DrItanium/i960SxProcessorCard/README.md

A 4-layer PCB meant to break the control signals of an i960Sx processor in the
form of an Arduino Mega 2560 shield. I designed this board to make sure that I
would not have to continually make 4-layer boards on multiple screw ups.
