DrItanium/i960SxProcessorCard/i960SxProcessorMegaShieldFormFactor.kicad_pcb

## KiCad design i960SxProcessorMegaShieldFormFactor.kicad_pcb (2022-12-09)

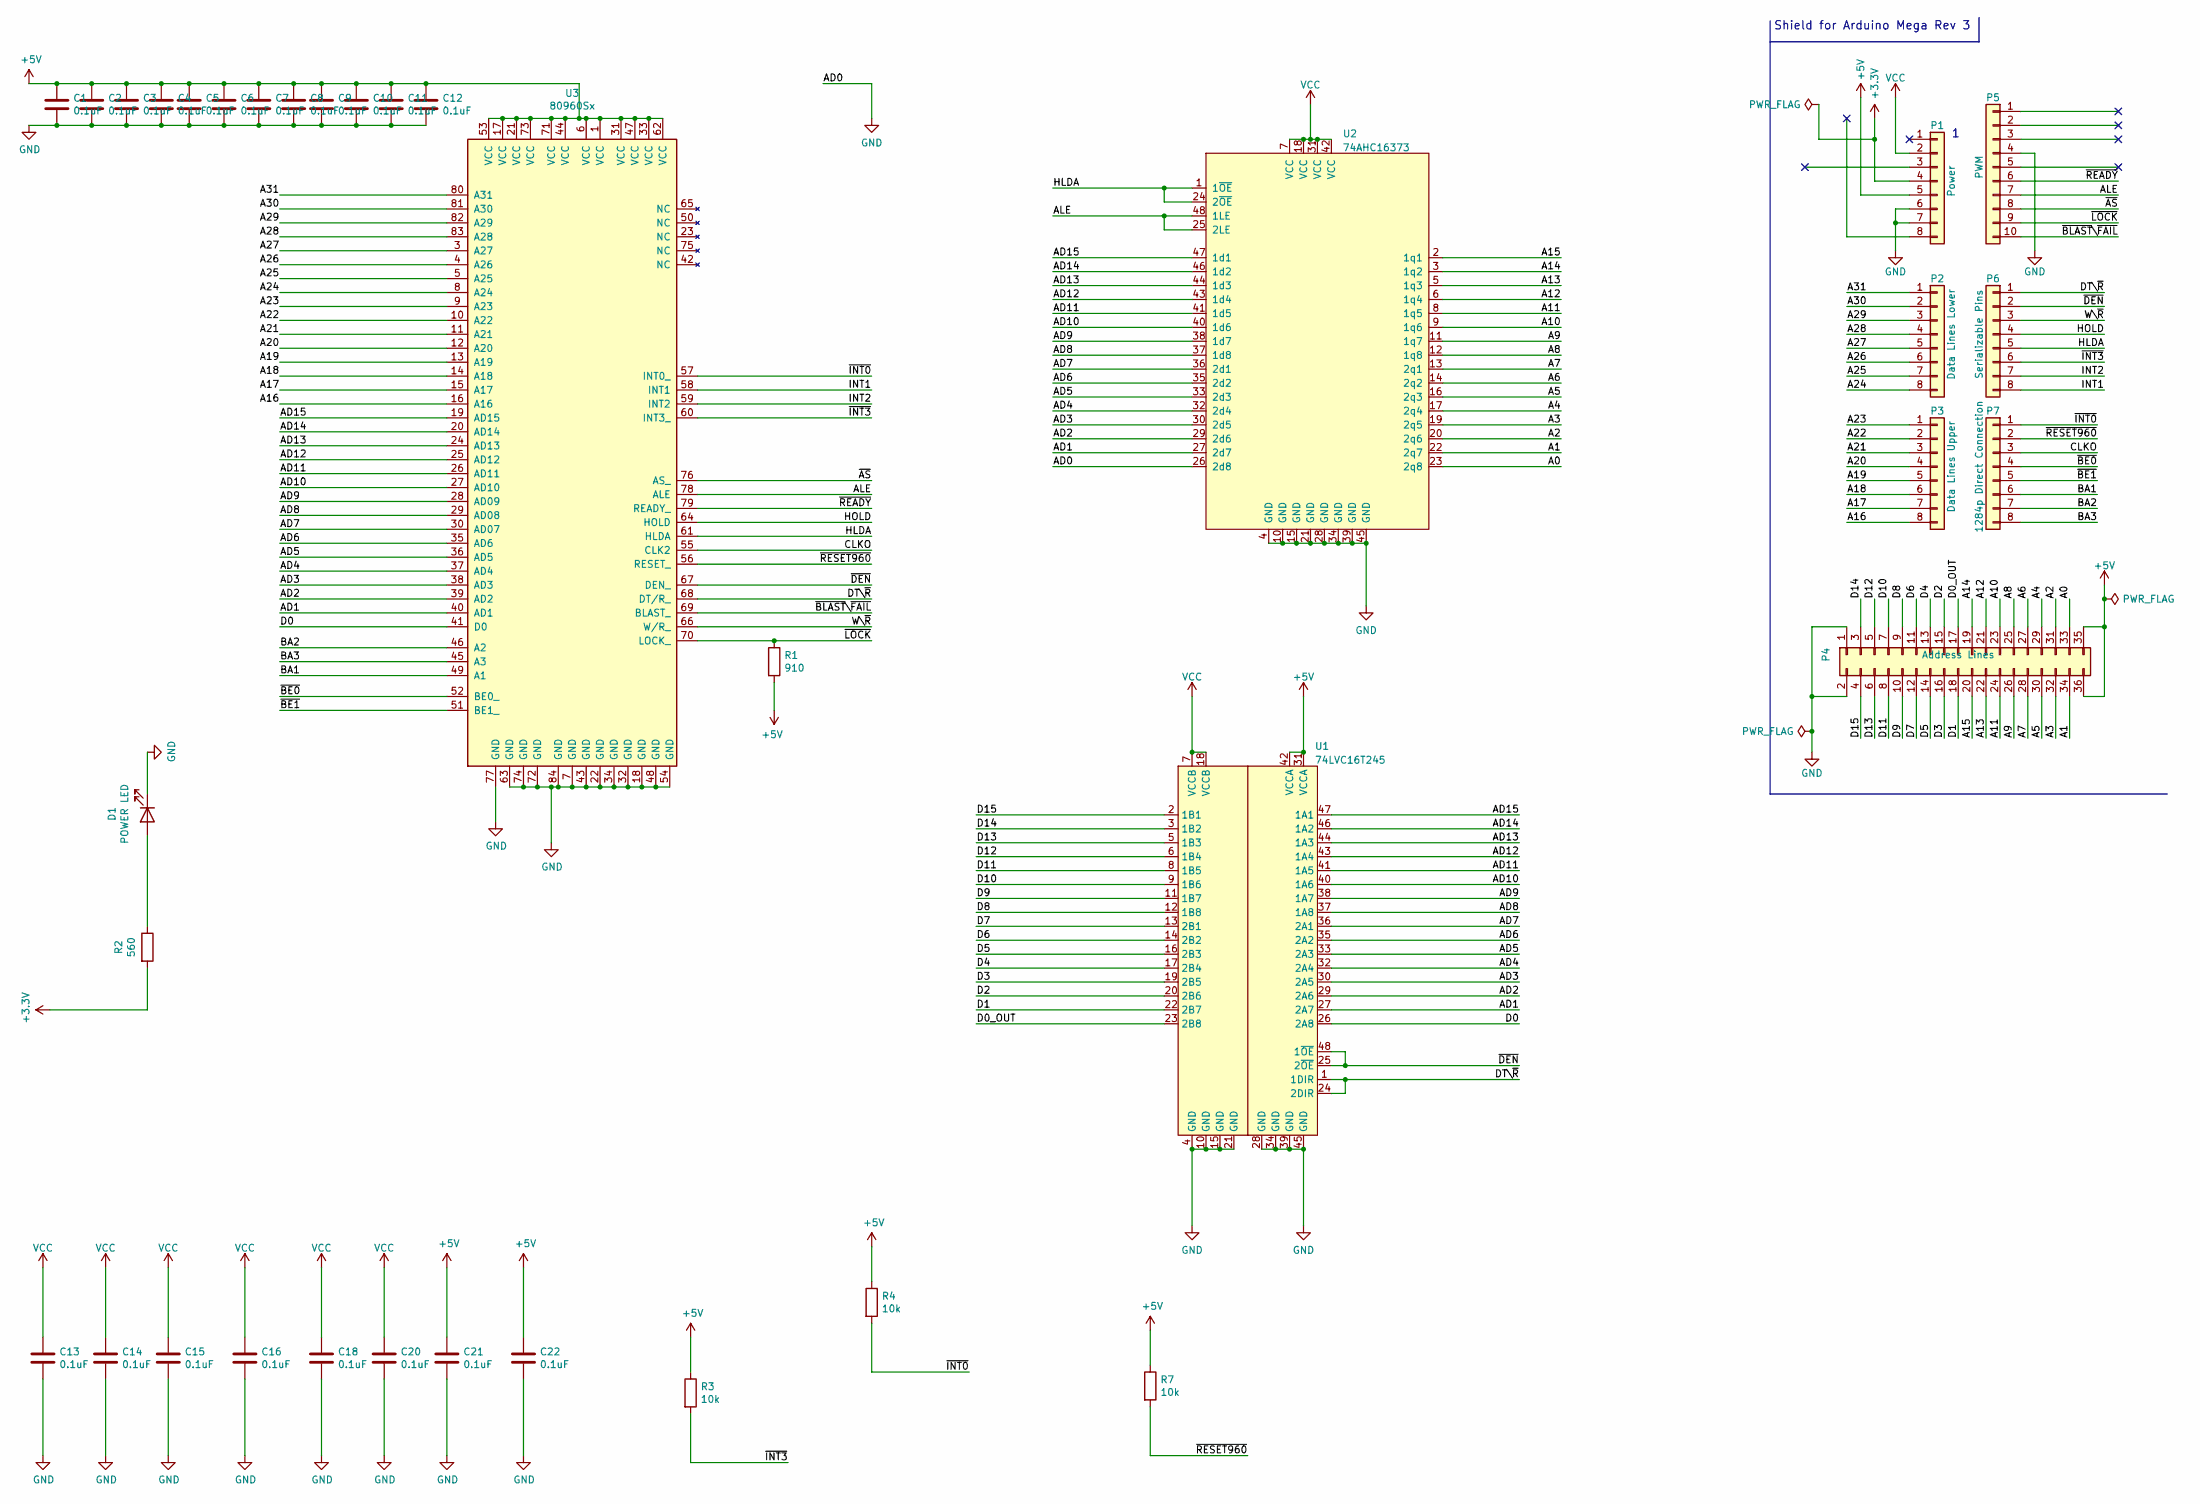
[picture p1: schematic i960SxProcessorMegaShieldFormFactor.kicad_sch, i960Sx Mega Shield Without direct connection to a mega]

Parts:
C1, C2, C3, C4, C5, C6, C7, C8, C9, C10, C11, C12, C13, C14, C15, C16, C18, C20, C21, C22: 0.1uF; C_0805_2012Metric_Pad1.18x1.45mm_HandSolder
D1: POWER LED; LED_0805_2012Metric
P1: Power; Socket_Strip_Arduino_1x08
P2: Data Lines Lower; Socket_Strip_Arduino_1x08
P3: Data Lines Upper; Socket_Strip_Arduino_1x08
P4: Address Lines; Socket_Strip_Arduino_2x18
P5: PWM; Socket_Strip_Arduino_1x10
P6: Serializable Pins; Socket_Strip_Arduino_1x08
P7: 1284p Direct Connection; Socket_Strip_Arduino_1x08
R1: 910; R_0805_2012Metric_Pad1.20x1.40mm_HandSolder
R2: 560; R_0805_2012Metric_Pad1.20x1.40mm_HandSolder
R3, R4, R7: 10k; R_0805_2012Metric_Pad1.20x1.40mm_HandSolder
U1: 74LVC16T245; TSSOP-48_6.1x12.5mm_P0.5mm
U2: 74AHC16373; TSSOP-48_6.1x12.5mm_P0.5mm
U3: 80960Sx; PLCC-84_THT-Socket

Connections:
+3V3: P1.4, R2.2
+5V: C1.1, C2.1, C3.1, C4.1, C5.1, C6.1, C7.1, C8.1, C9.1, C10.1, C11.1, C12.1, C21.1, C22.1, P1.5, P4.35, P4.36, R1.2, R3.1, R4.1, R7.1, U1.31 (VCCA), U1.42 (VCCA), U3.1 (VCC), U3.6 (VCC), U3.17 (VCC), U3.21 (VCC), U3.31 (VCC), U3.33 (VCC), U3.44 (VCC), U3.47 (VCC), U3.53 (VCC), U3.62 (VCC), U3.71 (VCC), U3.73 (VCC)
/A0: P4.33, U2.23 (2q8)
/A1: P4.34, U2.22 (2q7)
/A2: P4.31, U2.20 (2q6)
/A3: P4.32, U2.19 (2q5)
/A4: P4.29, U2.17 (2q4)
/A5: P4.30, U2.16 (2q3)
/A6: P4.27, U2.14 (2q2)
/A7: P4.28, U2.13 (2q1)
/A8: P4.25, U2.12 (1q8)
/A9: P4.26, U2.11 (1q7)
/A10: P4.23, U2.9 (1q6)
/A11: P4.24, U2.8 (1q5)
/A12: P4.21, U2.6 (1q4)
/A13: P4.22, U2.5 (1q3)
/A14: P4.19, U2.3 (1q2)
/A15: P4.20, U2.2 (1q1)
/A16: P3.8, U3.16 (A16)
/A17: P3.7, U3.15 (A17)
/A18: P3.6, U3.14 (A18)
/A19: P3.5, U3.13 (A19)
/A20: P3.4, U3.12 (A20)
/A21: P3.3, U3.11 (A21)
/A22: P3.2, U3.10 (A22)
/A23: P3.1, U3.9 (A23)
/A24: P2.8, U3.8 (A24)
/A25: P2.7, U3.5 (A25)
/A26: P2.6, U3.4 (A26)
/A27: P2.5, U3.3 (A27)
/A28: P2.4, U3.83 (A28)
/A29: P2.3, U3.82 (A29)
/A30: P2.2, U3.81 (A30)
/A31: P2.1, U3.80 (A31)
/AD1: U1.27 (2A7), U2.27 (2d7), U3.40 (AD1)
/AD2: U1.29 (2A6), U2.29 (2d6), U3.39 (AD2)
/AD3: U1.30 (2A5), U2.30 (2d5), U3.38 (AD3)
/AD4: U1.32 (2A4), U2.32 (2d4), U3.37 (AD4)
/AD5: U1.33 (2A3), U2.33 (2d3), U3.36 (AD5)
/AD6: U1.35 (2A2), U2.35 (2d2), U3.35 (AD6)
/AD7: U1.36 (2A1), U2.36 (2d1), U3.30 (AD07)
/AD8: U1.37 (1A8), U2.37 (1d8), U3.29 (AD08)
/AD9: U1.38 (1A7), U2.38 (1d7), U3.28 (AD09)
/AD10: U1.40 (1A6), U2.40 (1d6), U3.27 (AD10)
/AD11: U1.41 (1A5), U2.41 (1d5), U3.26 (AD11)
/AD12: U1.43 (1A4), U2.43 (1d4), U3.25 (AD12)
/AD13: U1.44 (1A3), U2.44 (1d3), U3.24 (AD13)
/AD14: U1.46 (1A2), U2.46 (1d2), U3.20 (AD14)
/AD15: U1.47 (1A1), U2.47 (1d1), U3.19 (AD15)
/ALE: P5.7, U2.25 (2LE), U2.48 (1LE), U3.78 (ALE)
/BA1: P7.6, U3.49 (A1)
/BA2: P7.7, U3.46 (A2)
/BA3: P7.8, U3.45 (A3)
/CLKO: P7.3, U3.55 (CLK2)
/D0: U1.26 (2A8), U3.41 (D0)
/D0_OUT: P4.17, U1.23 (2B8)
/D1: P4.18, U1.22 (2B7)
/D2: P4.15, U1.20 (2B6)
/D3: P4.16, U1.19 (2B5)
/D4: P4.13, U1.17 (2B4)
/D5: P4.14, U1.16 (2B3)
/D6: P4.11, U1.14 (2B2)
/D7: P4.12, U1.13 (2B1)
/D8: P4.9, U1.12 (1B8)
/D9: P4.10, U1.11 (1B7)
/D10: P4.7, U1.9 (1B6)
/D11: P4.8, U1.8 (1B5)
/D12: P4.5, U1.6 (1B4)
/D13: P4.6, U1.5 (1B3)
/D14: P4.3, U1.3 (1B2)
/D15: P4.4, U1.2 (1B1)
/DT\~R: P6.1, U1.1 (1DIR), U1.24 (2DIR), U3.68 (DT/R_)
/HLDA: P6.5, U2.1 (1~OE), U2.24 (2~OE), U3.61 (HLDA)
/HOLD: P6.4, U3.64 (HOLD)
/INT1: P6.8, U3.58 (INT1)
/INT2: P6.7, U3.59 (INT2)
/W\~R: P6.3, U3.66 (W/R_)
/~AS: P5.8, U3.76 (AS_)
/~BE0: P7.4, U3.52 (BE0_)
/~BE1: P7.5, U3.51 (BE1_)
/~BLAST\~FAIL: P5.10, U3.69 (BLAST_)
/~DEN: P6.2, U1.25 (2~OE), U1.48 (1~OE), U3.67 (DEN_)
/~INT0: P7.1, R4.2, U3.57 (INT0_)
/~INT3: P6.6, R3.2, U3.60 (INT3_)
/~LOCK: P5.9, R1.1, U3.70 (LOCK_)
/~READY: P5.6, U3.79 (READY_)
/~RESET960: P7.2, R7.2, U3.56 (RESET_)
GND: C1.2, C2.2, C3.2, C4.2, C5.2, C6.2, C7.2, C8.2, C9.2, C10.2, C11.2, C12.2, C13.2, C14.2, C15.2, C16.2, C18.2, C20.2, C21.2, C22.2, D1.1 (K), P1.6, P1.7, P4.1, P4.2, P5.4, U1.4 (GND), U1.10 (GND), U1.15 (GND), U1.21 (GND), U1.28 (GND), U1.34 (GND), U1.39 (GND), U1.45 (GND), U2.4 (GND), U2.10 (GND), U2.15 (GND), U2.21 (GND), U2.26 (2d8), U2.28 (GND), U2.34 (GND), U2.39 (GND), U2.45 (GND), U3.7 (GND), U3.18 (GND), U3.22 (GND), U3.32 (GND), U3.34 (GND), U3.43 (GND), U3.48 (GND), U3.54 (GND), U3.63 (GND), U3.72 (GND), U3.74 (GND), U3.77 (GND), U3.84 (GND)
unnamed: D1.2 (A), R2.1
VCC: C13.1, C14.1, C15.1, C16.1, C18.1, C20.1, P1.2, U1.7 (VCCB), U1.18 (VCCB), U2.7 (VCC), U2.18 (VCC), U2.31 (VCC), U2.42 (VCC)

Notes on the sheet:
Shield for Arduino Mega Rev 3

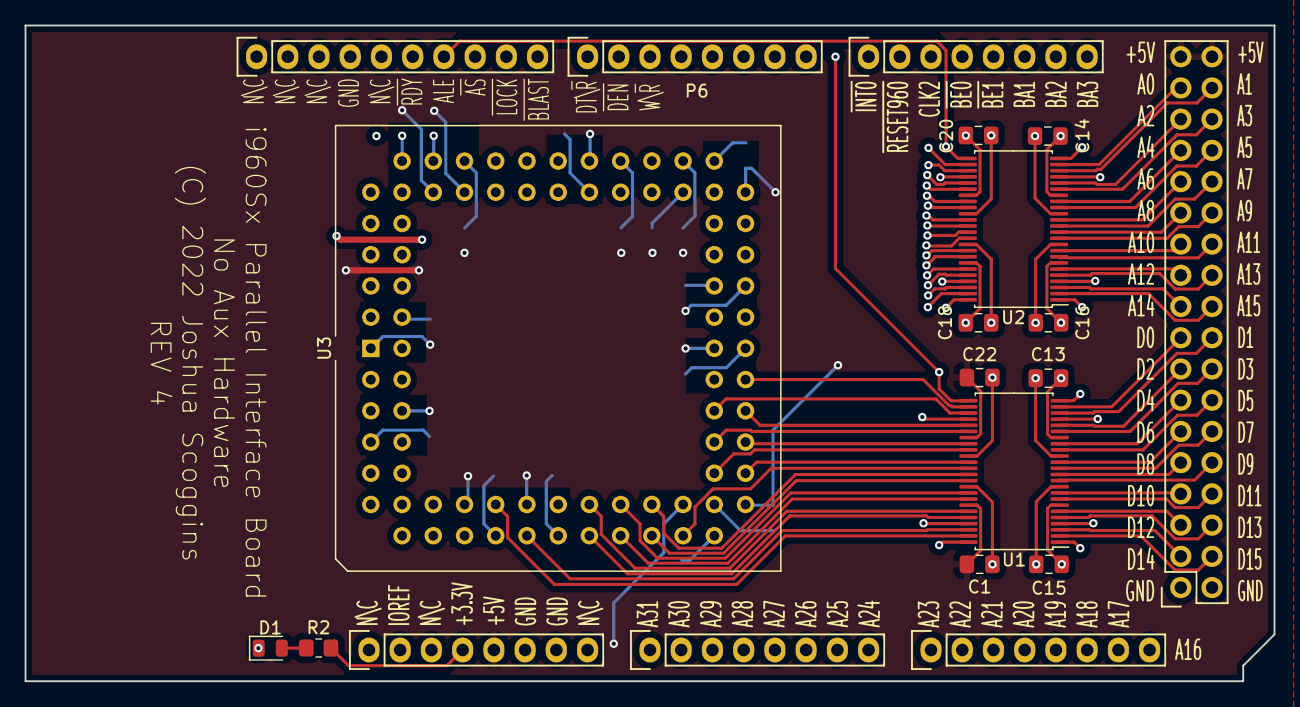
[picture p2: board i960SxProcessorMegaShieldFormFactor.kicad_pcb from above]

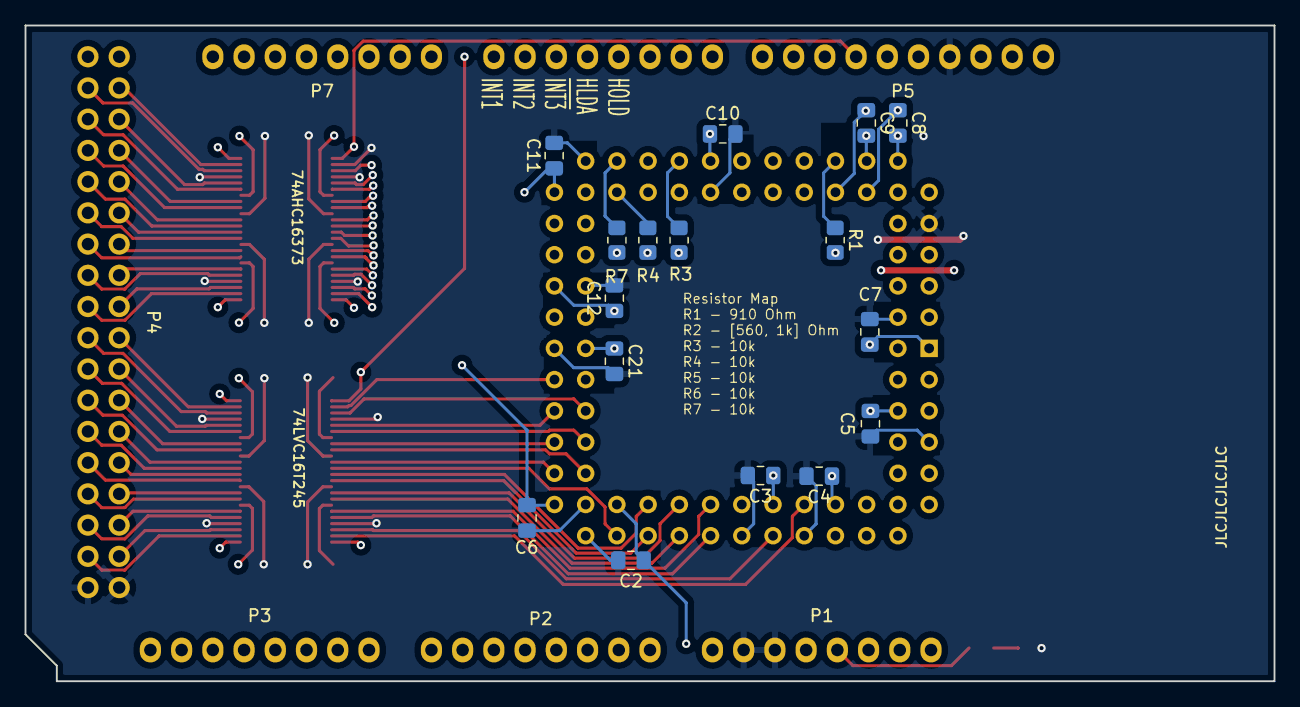
[picture p3: board i960SxProcessorMegaShieldFormFactor.kicad_pcb from below]

Board: 4 copper layers, 101.6 x 53.3 mm, 36 parts (16 on the bottom side), 90 nets.
