DrItanium/i960SxProcessorCard/(commit log)

2021-10-21 Initial rev 1 commit
    [ExternalHardware.sch, i960SxProcessorMegaShieldFormFactor.kicad_pcb, i960SxProcessorMegaShieldFormFactor.sch]
2021-10-21 Added CC-BY-SA silk screen
    [i960SxProcessorMegaShieldFormFactor.kicad_pcb]
2021-10-21 link up pre-existing external hardware
    Fix errors and make sure we are using AHC parts
    [ExternalHardware.sch, i960SxProcessorMegaShieldFormFactor.sch]
2021-10-21 Start placing different ics
    [i960SxProcessorMegaShieldFormFactor.kicad_pcb]
2021-10-21 Rearrange some connections and try to shove the aux hardware closer together
    [ExternalHardware.sch, i960SxProcessorMegaShieldFormFactor.kicad_pcb]
2021-10-21 Move the transceivers and registers to make room for the aux hardware
    [i960SxProcessorMegaShieldFormFactor.kicad_pcb, i960SxProcessorMegaShieldFormFactor.sch]
2021-10-21 Mostly complete rewiring
    [i960SxProcessorMegaShieldFormFactor.kicad_pcb, i960SxProcessorMegaShieldFormFactor.sch]
2021-10-21 Save the added pullup resistor
    [i960SxProcessorMegaShieldFormFactor.sch]
2021-10-21 Finish wiring the last two non power pins
    [i960SxProcessorMegaShieldFormFactor.kicad_pcb]
2021-10-21 added a track for the 3.3v power led
    [i960SxProcessorMegaShieldFormFactor.kicad_pcb]
2021-10-21 Finished initial design
    Still need to update the silk screens
    [i960SxProcessorMegaShieldFormFactor.kicad_pcb]
2021-10-21 Put the data and address lines back into the previous design
    Maximizes compatibility?
    [i960SxProcessorMegaShieldFormFactor.kicad_pcb, i960SxProcessorMegaShieldFormFactor.sch]
2021-10-21 Fix labeling
    [i960SxProcessorMegaShieldFormFactor.kicad_pcb]
2021-10-21 Rearrange aux hardware to reduce via count
    Start routing the rest of the traces out of the i960
    [ExternalHardware.sch, i960SxProcessorMegaShieldFormFactor.kicad_pcb]
2021-10-21 Finished non power routing
    [i960SxProcessorMegaShieldFormFactor.kicad_pcb]
2021-10-21 Power routing done?
    [i960SxProcessorMegaShieldFormFactor.kicad_pcb]
2021-10-21 Added documentation text
    [i960SxProcessorMegaShieldFormFactor.kicad_pcb]
2021-10-21 Text addons done
    [i960SxProcessorMegaShieldFormFactor.kicad_pcb]
2021-10-21 Add missing labelling
    [i960SxProcessorMegaShieldFormFactor.kicad_pcb]
2021-10-21 expose clock signal div 2
    [ExternalHardware.sch, i960SxProcessorMegaShieldFormFactor.sch]
2021-10-21 connect 10mhz clock to compatible output pin
    [i960SxProcessorMegaShieldFormFactor.kicad_pcb]
2021-10-21 Connect MCU_RDY to ~READY pin
    In the old designs, the ~READY pin was never used outside of the stack
    and the ~MCU_RDY pin was used in its place. I want to now make it so
    that using ~READY will always be synchronized. But the older rev1 cards
    directly connect ready to the i960Sx
    [i960SxProcessorMegaShieldFormFactor.kicad_pcb, i960SxProcessorMegaShieldFormFactor.sch]
2021-10-21 Make sure we connect ~MCU_RDY to ~READY to make the design backwards compatible
    I can reuse the two stack version of the processor card interface in
    future designs as well.
    [i960SxProcessorMegaShieldFormFactor.kicad_pcb]
2021-10-21 Make sure...
    [i960SxProcessorMegaShieldFormFactor.kicad_pcb]
2022-11-12 More fix up actions
    [i960SxProcessorMegaShieldFormFactor.kicad_pcb]
2022-11-12 ExternalHardware added
    [ExternalHardware.kicad_sch]
2022-11-12 Use a GAL chip to consolidate the number of chips
    I have many extra free entries on the GAL to assist me in doing stuff
    [ExternalHardware.kicad_sch, i960SxProcessorMegaShieldFormFactor.kicad_pcb]
2022-11-12 Whoops, missing the kicad 6 files :/
    [ExternalHardware.kicad_sch, i960SxProcessorMegaShieldFormFactor.kicad_sch]
2022-11-13 Use PLCC20 for the GAL chip instead of the much larger DIP20
    [ExternalHardware.kicad_sch, i960SxProcessorMegaShieldFormFactor.kicad_sch]
2022-11-13 Introduce the 74LVC16T245 for the datalines
    [ExternalHardware.kicad_sch, i960SxProcessorMegaShieldFormFactor.kicad_sch]
2022-11-13 Just do the consolidation
    [ExternalHardware.kicad_sch, i960SxProcessorMegaShieldFormFactor.kicad_pcb, i960SxProcessorMegaShieldFormFactor.kicad_sch]
2022-11-13 Finished retracing
    [i960SxProcessorMegaShieldFormFactor.kicad_pcb, i960SxProcessorMegaShieldFormFactor.kicad_sch]
2022-11-13 Update tags and add GAL16V8 script
    [i960SxProcessorMegaShieldFormFactor.kicad_pcb]
2022-11-13 Finished initial design
    [i960SxProcessorMegaShieldFormFactor.kicad_pcb]
2022-12-08 Remove a resistor and drop the 10MHz output clock
    [ExternalHardware.kicad_sch, i960SxProcessorMegaShieldFormFactor.kicad_sch]
2022-12-08 Broke the link
    [ExternalHardware.kicad_sch, i960SxProcessorMegaShieldFormFactor.kicad_sch]
2022-12-08 Remove the external hardware sheet
    We want to keep this board as simple as possible
    Having the extra signal setups is not a smart move it seems
    [i960SxProcessorMegaShieldFormFactor.kicad_sch]
2022-12-08 Clean up all of the aux hardware and put the capacitors in the area underneath the socket
    It makes it much cleaner
    Also, I made sure that the ground and power planes are on all layers to
    reduce complexity
    [i960SxProcessorMegaShieldFormFactor.kicad_pcb]
2022-12-09 Finished wiring
    Super easy this way :)
    [i960SxProcessorMegaShieldFormFactor.kicad_pcb]
2022-12-09 Finished the new implementation
    [i960SxProcessorMegaShieldFormFactor.kicad_pcb]
2022-12-09 gerber files
    [i960SxProcessorMegaShieldFormFactor-B_Mask.gbs, i960SxProcessorMegaShieldFormFactor-B_Paste.gbp, i960SxProcessorMegaShieldFormFactor-B_Silkscreen.gbo, i960SxProcessorMegaShieldFormFactor-Back.gbl, i960SxProcessorMegaShieldFormFactor-Edge_Cuts.gm1, i960SxProcessorMegaShieldFormFactor-F_Mask.gts, i960SxProcessorMegaShieldFormFactor-F_Paste.gtp, i960SxProcessorMegaShieldFormFactor-F_Silkscreen.gto]
