DrItanium/i960SxProcessorCard/(notices)

Notices in the files:
i960SxProcessorMegaShieldFormFactor.kicad_pcb:
(C) 2022 Joshua Scoggins
